bitbarista/mosaic/hardware/jig/pin_jig_iso.png

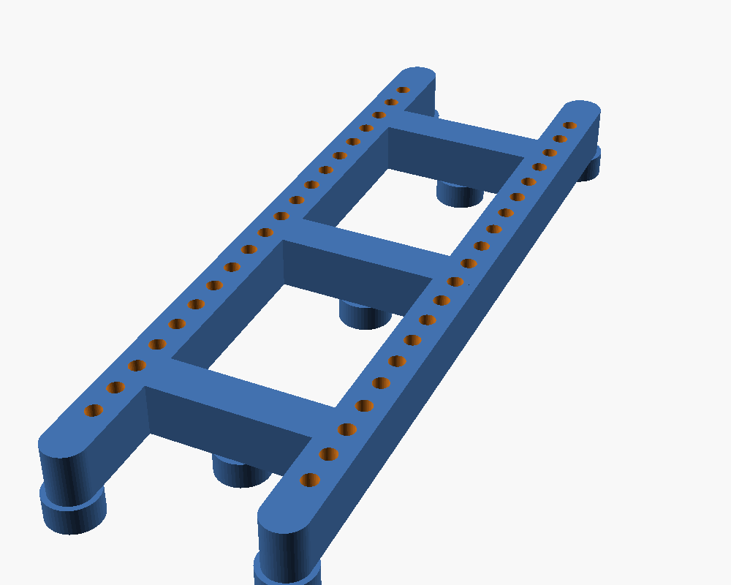
hardware/jig/pin_jig_iso.png
