bitbarista/mosaic/hardware/jig/pin_jig_top.png

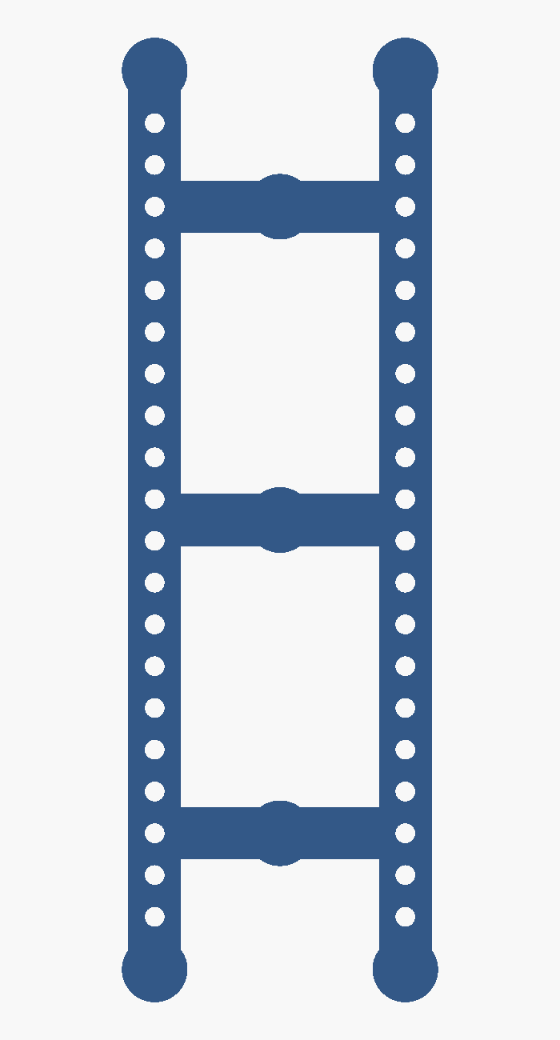
hardware/jig/pin_jig_top.png
