bitbarista/mosaic/hardware/plot/back.png

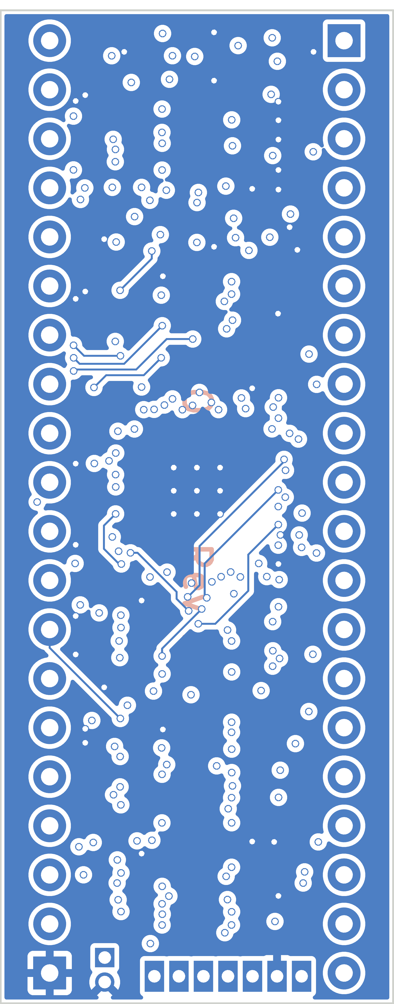
hardware/plot/back.png
