bitbarista/mosaic/hardware/plot/front.png

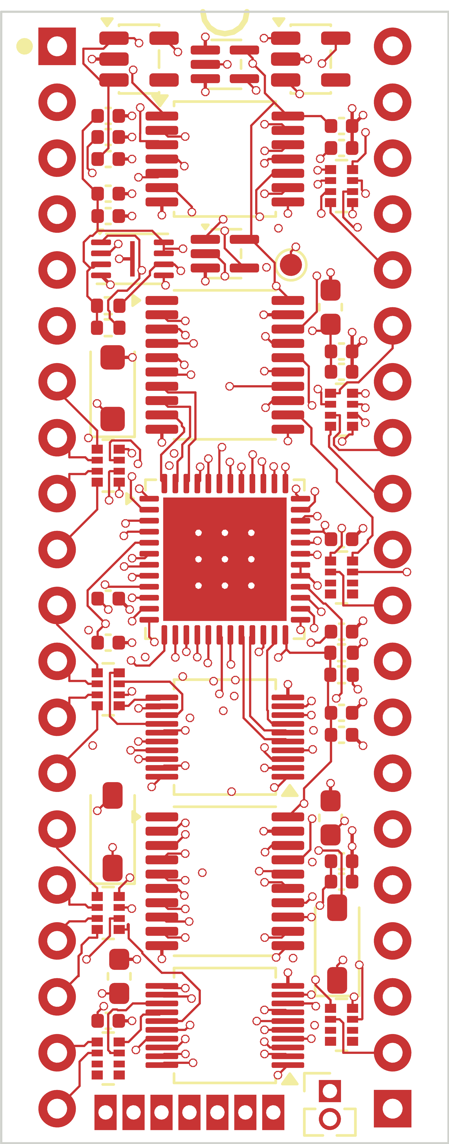
hardware/plot/front.png
