bitbarista/mosaic/hardware/render/mosaic_bottom.png

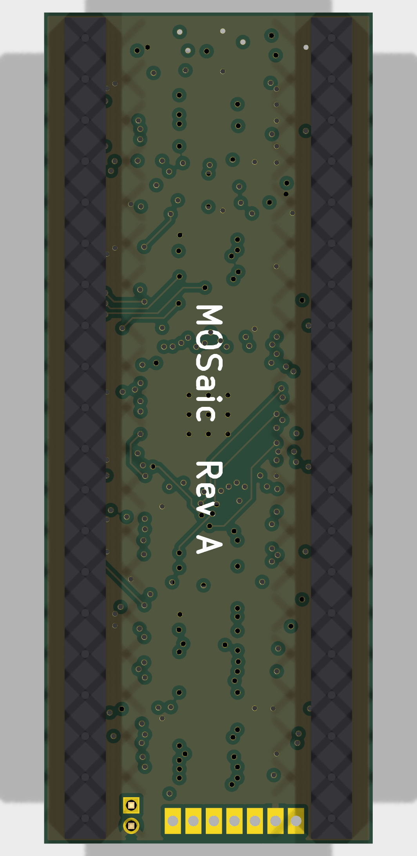
hardware/render/mosaic_bottom.png
