bitbarista/mosaic/hardware/render/mosaic_iso.png

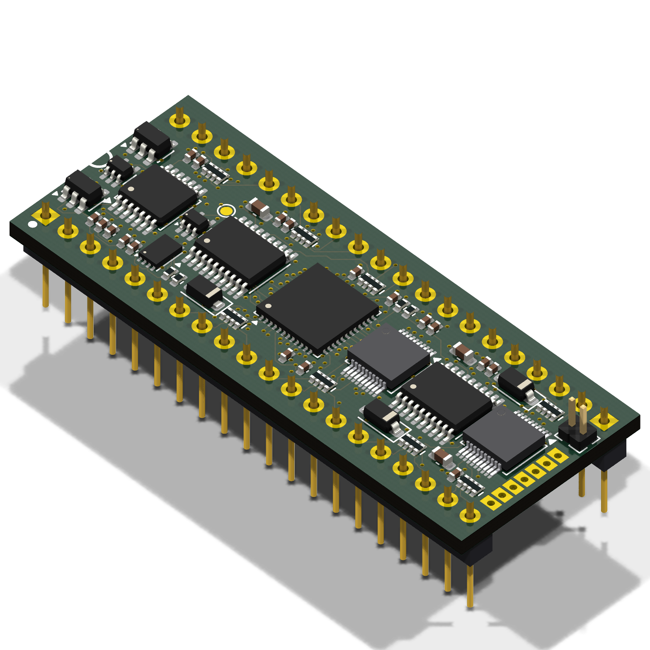
hardware/render/mosaic_iso.png
