bitbarista/mosaic/hardware/render/mosaic_top.png

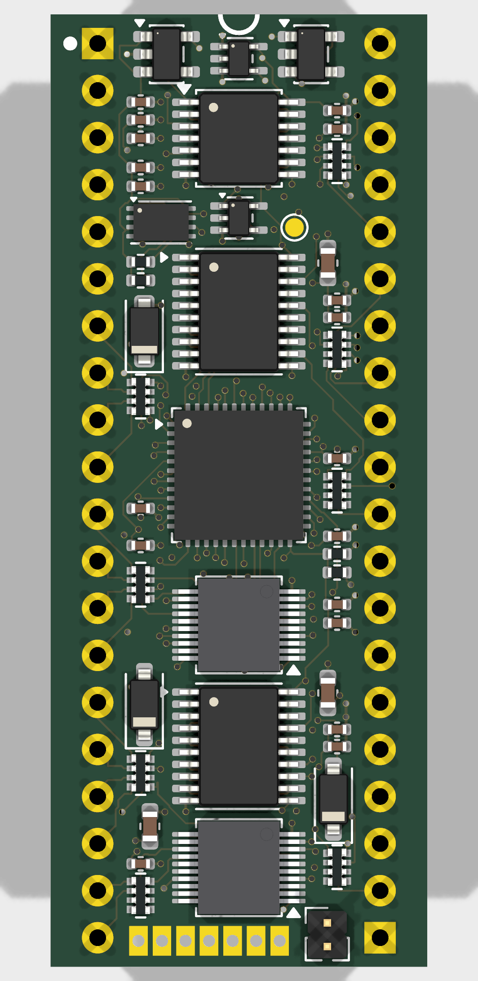
hardware/render/mosaic_top.png
