bitbarista/mosaic/hardware/jlcpcb-reva/mosaic-reva-bom.csv

Comment | Designator | Footprint | LCSC Part #
100n | C1,C10,C11,C12,C13,C14,C2,C3,C4,C5,C6,C7,C8,C9 | C_0402_1005Metric | C1525
4u7 | C15,C16,C17 | C_0603_1608Metric | C19666
1u | C18,C19,C20,C21 | C_0402_1005Metric | C52923
SMF6.0A | D1 | D_SOD-123F | C178260
B5819W | D2,D3 | D_SOD-123 | C8598
10k | R1,R2,R3,R4 | R_0402_1005Metric | C25744
33R x4 array | RN1,RN2,RN3,RN4,RN5,RN6,RN7,RN8 | R_Array_Convex_4x0402 | C25501
ICE40UP5K-SG48I | U1 | QFN-48-1EP_7x7mm_P0.5mm_EP5.6x5.6mm | C2678152
SN74CB3T3245PWR | U2,U3 | TSSOP-20_4.4x6.5mm_P0.65mm | C15298
SN74LVC541ADGVR | U4,U5 | TSSOP-20_4.4x5mm_P0.4mm | C2675530
SN74LVC1G125DCKR | U11,U6 | SOT-353_SC-70-5 | C7833
SN74LVC14APWR | U7 | TSSOP-14_4.4x5mm_P0.65mm | C7663
W25Q16JVUXIQ | U8 | Winbond_USON-8-1EP_3x2mm_P0.5mm_EP0.2x1.6mm | C2843335
NCP115ASN330T2G | U9 | SOT-23-5 | C603505
ME6211C12M5G-N | U10 | SOT-23-5 | C236672
