bitbarista/mosaic/hardware/jig/pin_jig.stl

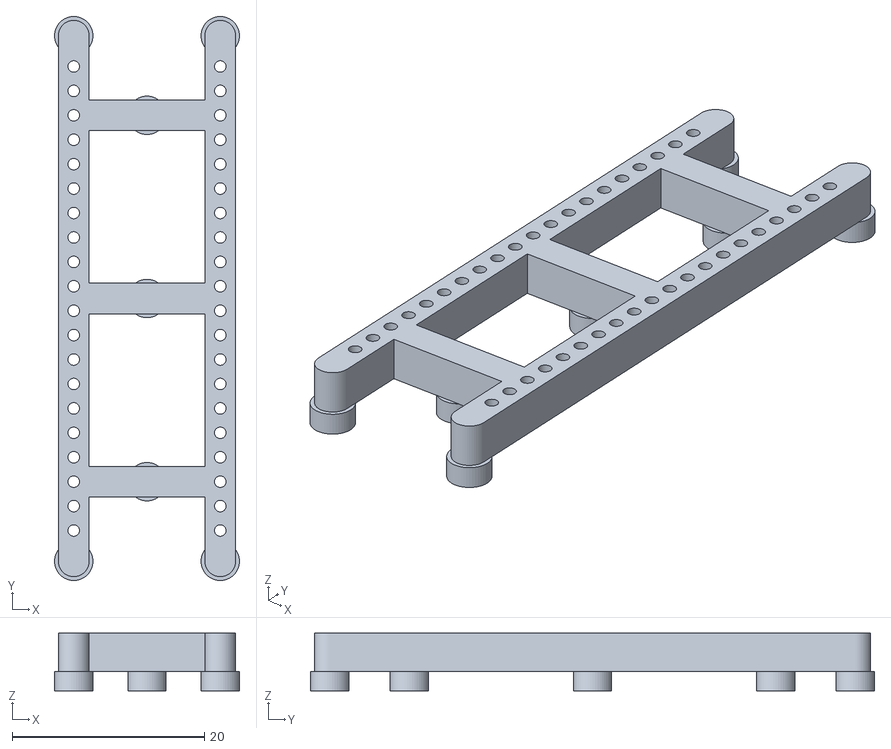
[picture p10: CAD file, 2026-10-20]
hardware/jig/pin_jig.stl
19.2 x 58.7 x 6.00
