bitbarista/mosaic/hardware/render/mosaic_assembled.png

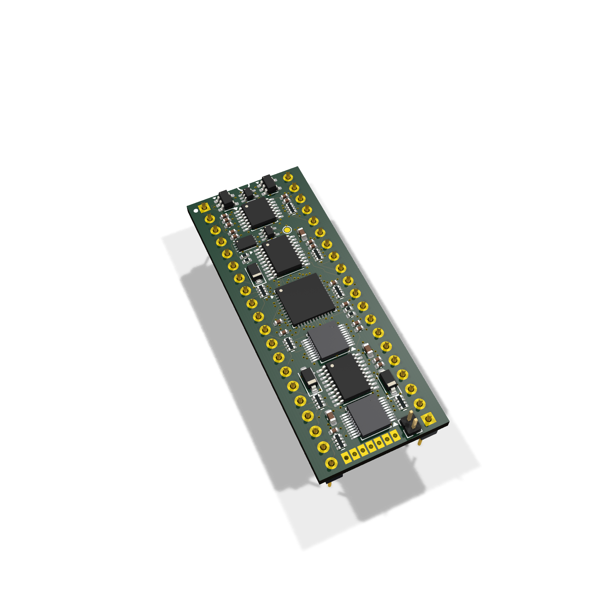
hardware/render/mosaic_assembled.png
