bitbarista/mosaic/hardware/mosaic-sch.pdf

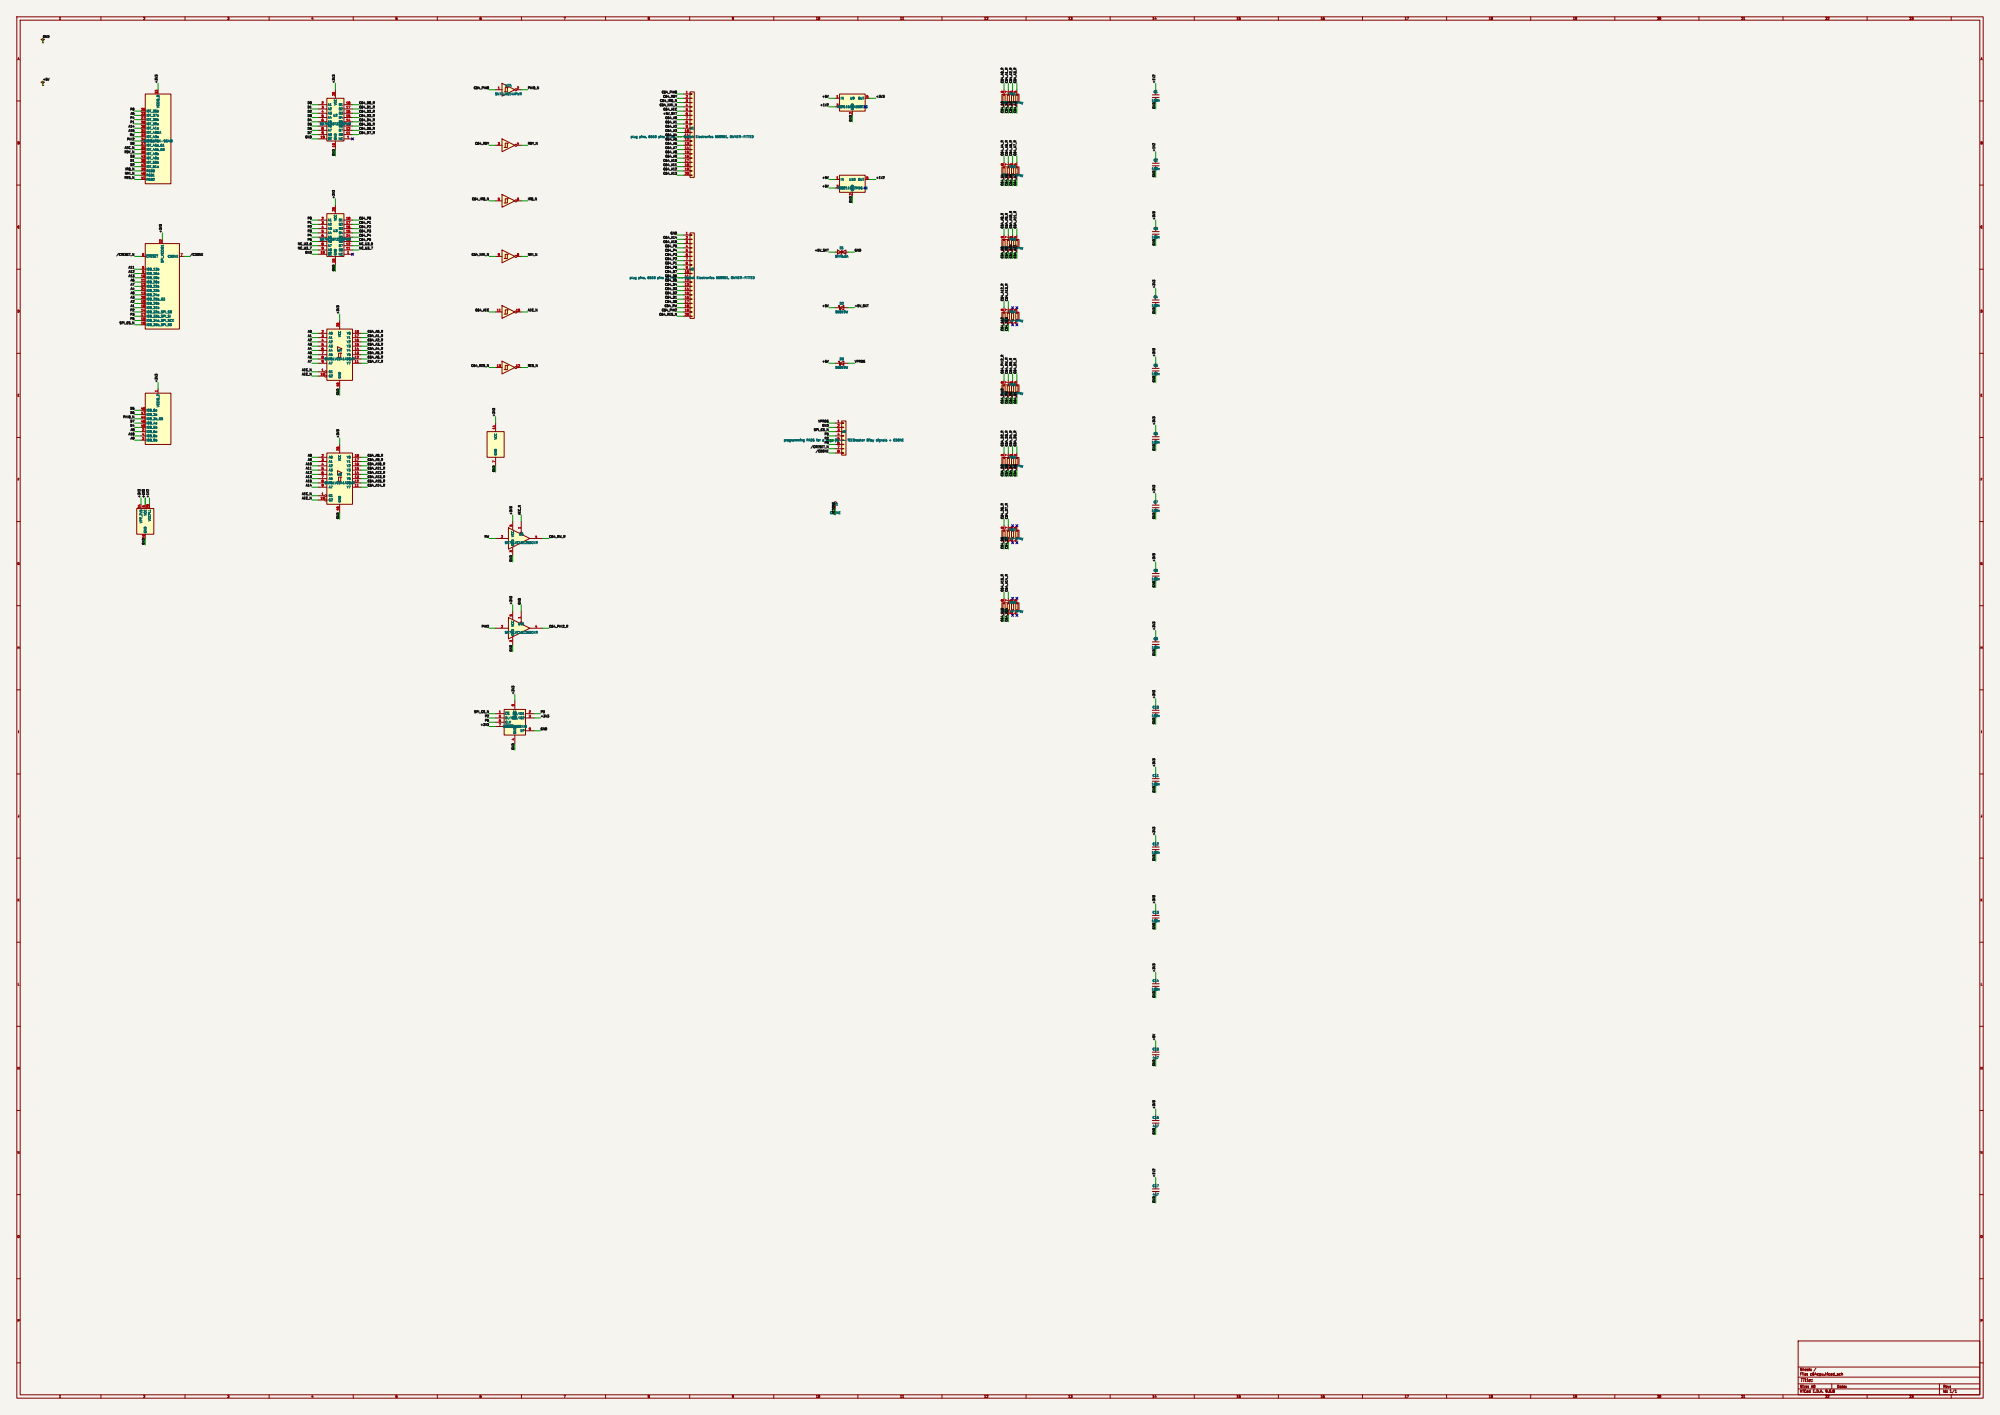
[picture p12: page 1]

Id: 1/1 Title: File: c64cpu.kicad_sch Sheet: /
