bitbarista/mosaic/hardware/mosaic-reva.kicad_pcb

## KiCad design hardware/mosaic-reva.kicad_pcb (2026-10-20)

Schematic: mosaic.kicad_sch

Parts:
C1, C2, C3, C4, C5, C6, C7, C8, C9, C10, C11, C12, C13, C14: 100n; C_0402_1005Metric
C15, C16, C17: 4u7; C_0603_1608Metric
C18, C19, C20, C21: 1u; C_0402_1005Metric
D1: SMF6.0A; D_SOD-123F
D2, D3: B5819W; D_SOD-123
J1: plug pins, 6510 pins 1-20 -- Switch Electronics 5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; PlugHeader_1x20_P2.54mm_Machined
J2: plug pins, 6510 pins 21-40 -- Switch Electronics 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; PlugHeader_1x20_P2.54mm_Machined
J3: programming PADS for a pogo jig -- the iCEBreaker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; ProgPads_1x07_P1.27mm
J4: PROG_EN jumper -- bridge to enable flash writes (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; PinHeader_1x02_P2.54mm_Vertical
R1, R2, R3, R4: 10k; R_0402_1005Metric
RN1, RN2, RN3, RN4, RN5, RN6, RN7, RN8: 33R x4 array; R_Array_Convex_4x0402
TP1: CDONE; TestPoint_Pad_D1.0mm
U1: ICE40UP5K-SG48I; QFN-48-1EP_7x7mm_P0.5mm_EP5.6x5.6mm
U2, U3: SN74CB3T3245PWR; TSSOP-20_4.4x6.5mm_P0.65mm
U4, U5: SN74LVC541ADGVR; TSSOP-20_4.4x5mm_P0.4mm
U6, U11: SN74LVC1G125DCKR; SOT-353_SC-70-5
U7: SN74LVC14APWR; TSSOP-14_4.4x5mm_P0.65mm
U8: W25Q16JVUXIQ; Winbond_USON-8-1EP_3x2mm_P0.5mm_EP0.2x1.6mm
U9: NCP115ASN330T2G; SOT-23-5
U10: ME6211C12M5G-N; SOT-23-5

Connections:
+1V2: C1.1, C2.1, C17.1, C19.1, U1.5 (VCC), U1.29 (VCCPLL), U1.30 (VCC), U9.3 (EN), U10.5 (OUT)
+3V3: C3.1, C4.1, C5.1, C6.1, C7.1, C8.1, C9.1, C10.1, C11.1, C12.1, C13.1, C14.1, C16.1, C21.1, R1.1, R2.1, R3.1, R4.1, U1.1 (VCCIO_2), U1.22 (SPI_VCCIO1), U1.24 (VPP_2V5), U1.33 (VCCIO_0), U2.20 (VCC), U3.20 (VCC), U4.20 (VCC), U5.20 (VCC), U6.5 (VCC), U7.14 (VCC), U8.3 (~WP/IO2), U8.7 (~HOLD/IO3), U8.8 (VCC), U9.5 (OUT), U11.5 (VCC)
+5V: C15.1, C18.1, C20.1, D2.1 (K), D3.1 (K), U9.1 (IN), U10.1 (IN), U10.3 (EN)
+5V_SKT: D1.1 (A1), D2.2 (A), J1.6
/CDONE: R3.2, TP1.1, U1.7 (CDONE)
/CRESET_N: J3.7, R1.2, U1.8 (~CRESET)
A0: U1.13 (IOB_24a), U4.2 (A0)
A1: U1.18 (IOB_31b), U4.3 (A1)
A2: U1.19 (IOB_29b), U4.4 (A2)
A3: U1.20 (IOB_25b_G3), U4.5 (A3)
A4: U1.21 (IOB_23b), U4.6 (A4)
A5: U1.23 (IOT_37a), U4.7 (A5)
A6: U1.11 (IOB_20a), U4.8 (A6)
A7: U1.12 (IOB_22a), U4.9 (A7)
A8: U1.2 (IOB_6a), U5.2 (A0)
A9: U1.3 (IOB_9b), U5.3 (A1)
A10: U1.4 (IOB_8a), U5.4 (A2)
A11: U1.6 (IOB_13b), U5.5 (A3)
A12: U1.9 (IOB_16a), U5.6 (A4)
A13: U1.10 (IOB_18a), U5.7 (A5)
A14: U1.28 (IOT_41a), U5.9 (A7)
A15: U1.31 (IOT_42b), U5.8 (A6)
AEC_N: U1.35 (IOT_46b_G0), U4.1 (G1), U4.19 (G2), U5.1 (G1), U5.19 (G2), U6.1, U7.10
C64_A0: J1.7, RN1.1 (R1.1)
C64_A0_R: RN1.8 (R1.2), U4.18 (Y0)
C64_A1: J1.8, RN1.2 (R2.1)
C64_A1_R: RN1.7 (R2.2), U4.17 (Y1)
C64_A2: J1.9, RN1.3 (R3.1)
C64_A2_R: RN1.6 (R3.2), U4.16 (Y2)
C64_A3: J1.10, RN1.4 (R4.1)
C64_A3_R: RN1.5 (R4.2), U4.15 (Y3)
C64_A4: J1.11, RN2.1 (R1.1)
C64_A4_R: RN2.8 (R1.2), U4.14 (Y4)
C64_A5: J1.12, RN2.2 (R2.1)
C64_A5_R: RN2.7 (R2.2), U4.13 (Y5)
C64_A6: J1.13, RN2.3 (R3.1)
C64_A6_R: RN2.6 (R3.2), U4.12 (Y6)
C64_A7: J1.14, RN2.4 (R4.1)
C64_A7_R: RN2.5 (R4.2), U4.11 (Y7)
C64_A8: J1.15, RN3.1 (R1.1)
C64_A8_R: RN3.8 (R1.2), U5.18 (Y0)
C64_A9: J1.16, RN3.2 (R2.1)
C64_A9_R: RN3.7 (R2.2), U5.17 (Y1)
C64_A10: J1.17, RN3.3 (R3.1)
C64_A10_R: RN3.6 (R3.2), U5.16 (Y2)
C64_A11: J1.18, RN3.4 (R4.1)
C64_A11_R: RN3.5 (R4.2), U5.15 (Y3)
C64_A12: J1.19, RN4.1 (R1.1)
C64_A12_R: RN4.8 (R1.2), U5.14 (Y4)
C64_A13: J1.20, RN4.2 (R2.1)
C64_A13_R: RN4.7 (R2.2), U5.13 (Y5)
C64_A14: J2.2, RN8.2 (R2.1)
C64_A14_R: RN8.7 (R2.2), U5.11 (Y7)
C64_A15: J2.3, RN8.1 (R1.1)
C64_A15_R: RN8.8 (R1.2), U5.12 (Y6)
C64_AEC: J1.5, U7.11
C64_D0: J2.17, RN5.3 (R3.1)
C64_D0_R: RN5.6 (R3.2), U2.18 (B1)
C64_D1: J2.16, RN5.4 (R4.1)
C64_D1_R: RN5.5 (R4.2), U2.17 (B2)
C64_D2: J2.15, RN6.1 (R1.1)
C64_D2_R: RN6.8 (R1.2), U2.16 (B3)
C64_D3: J2.14, RN6.2 (R2.1)
C64_D3_R: RN6.7 (R2.2), U2.15 (B4)
C64_D4: J2.13, RN6.3 (R3.1)
C64_D4_R: RN6.6 (R3.2), U2.14 (B5)
C64_D5: J2.12, RN6.4 (R4.1)
C64_D5_R: RN6.5 (R4.2), U2.13 (B6)
C64_D6: J2.11, RN7.1 (R1.1)
C64_D6_R: RN7.8 (R1.2), U2.12 (B7)
C64_D7: J2.10, RN7.2 (R2.1)
C64_D7_R: RN7.7 (R2.2), U2.11 (B8)
C64_IRQ_N: J1.3, U7.5
C64_NMI_N: J1.4, U7.9
C64_P0: J2.9, U3.18 (B1)
C64_P1: J2.8, U3.17 (B2)
C64_P2: J2.7, U3.16 (B3)
C64_P3: J2.6, U3.15 (B4)
C64_P4: J2.5, U3.14 (B5)
C64_P5: J2.4, U3.13 (B6)
C64_PHI0: J1.1, U7.1
C64_PHI2: J2.19, RN5.1 (R1.1)
C64_PHI2_R: RN5.8 (R1.2), U11.4
C64_RDY: J1.2, U7.3
C64_RES_N: J2.20, U7.13
C64_RW: J2.18, RN5.2 (R2.1)
C64_RW_R: RN5.7 (R2.2), U6.4
D0: U1.37 (IOT_45a_G1), U2.2 (A1)
D1: U1.38 (IOT_50b), U2.3 (A2)
D2: U1.42 (IOT_51a), U2.4 (A3)
D3: U1.43 (IOT_49a), U2.5 (A4)
D4: U1.45 (IOB_5b), U2.6 (A5)
D5: U1.46 (IOB_0a), U2.7 (A6)
D6: U1.47 (IOB_2a), U2.8 (A7)
D7: U1.48 (IOB_4a), U2.9 (A8)
GND: C1.2, C2.2, C3.2, C4.2, C5.2, C6.2, C7.2, C8.2, C9.2, C10.2, C11.2, C12.2, C13.2, C14.2, C15.2, C16.2, C17.2, C18.2, C19.2, C20.2, C21.2, D1.2 (A2), J2.1, J3.2, J4.2, U1.49 (GND), U2.10 (GND), U2.19 (~OE), U3.10 (GND), U3.19 (~OE), U4.10 (GND), U5.10 (GND), U6.3 (GND), U7.7 (GND), U8.4 (GND), U8.9 (EP), U9.2 (GND), U10.2 (GND), U11.1, U11.3 (GND)
IRQ_N: U1.39 (RGB0), U7.6
NC_U3_6: U3.8 (A7), U3.12 (B7)
NC_U3_7: U3.9 (A8), U3.11 (B8)
NMI_N: U1.40 (RGB1), U7.8
P0: U1.25 (IOT_36b), U3.2 (A1)
P1: U1.26 (IOT_39a), U3.3 (A2)
P2: J3.5, U1.14 (IOB_32a_SPI_SO), U3.4 (A3), U8.5 (DI/IO0)
P3: J3.6, U1.17 (IOB_33b_SPI_SI), U3.5 (A4), U8.2 (DO/IO1)
P4: J4.1, U1.27 (IOT_38b), U3.6 (A5)
P5: J3.4, R4.2, U1.15 (IOB_34a_SPI_SCK), U3.7 (A6), U8.6 (CLK)
PHI0_N: U1.44 (IOB_3b_G6), U7.2
PHI2: U1.34 (IOT_44b), U11.2
RDY_N: U1.36 (IOT_48b), U7.4
RES_N: U1.41 (RGB2), U7.12
RW: U1.32 (IOT_43a), U6.2
SPI_CS_N: J3.3, R2.2, U1.16 (IOB_35b_SPI_SS), U8.1 (~CS)
VPROG: D3.2 (A), J3.1

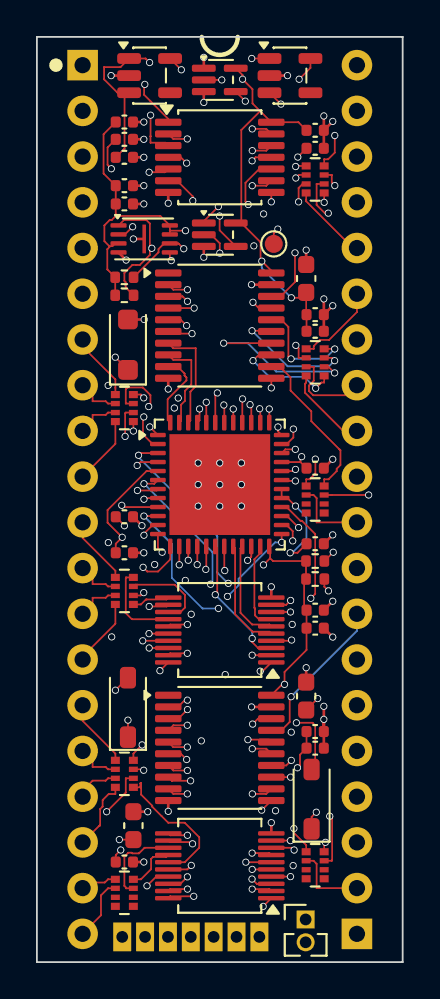
[picture p13: board mosaic-reva.kicad_pcb from above]

Board: 4 copper layers, 20.3 x 51.4 mm, 52 parts (0 on the bottom side), 113 nets.
