bitbarista/mosaic/syn/mosaic.pcf

# GENERATED by syn/gen_pcf.py from gen/design.py -- DO NOT EDIT.
# Every C64-facing pin is -pullup no; see the module docstring.

set_io -nowarn -pullup no A[8] 2
set_io -nowarn -pullup no A[9] 3
set_io -nowarn -pullup no A[10] 4
set_io -nowarn -pullup no A[11] 6
set_io -nowarn -pullup no A[12] 9
set_io -nowarn -pullup no A[13] 10
set_io -nowarn -pullup no A[6] 11
set_io -nowarn -pullup no A[7] 12
set_io -nowarn -pullup no A[0] 13
set_io -nowarn -pullup no P[2] 14
set_io -nowarn -pullup no P[5] 15
set_io -nowarn -pullup no SPI_CS_N 16
set_io -nowarn -pullup no P[3] 17
set_io -nowarn -pullup no A[1] 18
set_io -nowarn -pullup no A[2] 19
set_io -nowarn -pullup no A[3] 20
set_io -nowarn -pullup no A[4] 21
set_io -nowarn -pullup no A[5] 23
set_io -nowarn -pullup no P[0] 25
set_io -nowarn -pullup no P[1] 26
set_io -nowarn -pullup no P[4] 27
set_io -nowarn -pullup no A[14] 28
set_io -nowarn -pullup no A[15] 31
set_io -nowarn -pullup no RW 32
set_io -nowarn -pullup no PHI2 34
set_io -nowarn -pullup no AEC 35
set_io -nowarn -pullup no RDY 36
set_io -nowarn -pullup no D[0] 37
set_io -nowarn -pullup no D[1] 38
set_io -nowarn -pullup no IRQ_N 39
set_io -nowarn -pullup no NMI_N 40
set_io -nowarn -pullup no RES_N 41
set_io -nowarn -pullup no D[2] 42
set_io -nowarn -pullup no D[3] 43
set_io -nowarn -pullup no PHI0 44
set_io -nowarn -pullup no D[4] 45
set_io -nowarn -pullup no D[5] 46
set_io -nowarn -pullup no D[6] 47
set_io -nowarn -pullup no D[7] 48
