bitbarista/mosaic/(notices)

Notices in the files:
README.md:
License: hardware
License: code
